ABillBlakely/Iridium-ADC/docs/project definition/Images/printed_enclosure.jpg

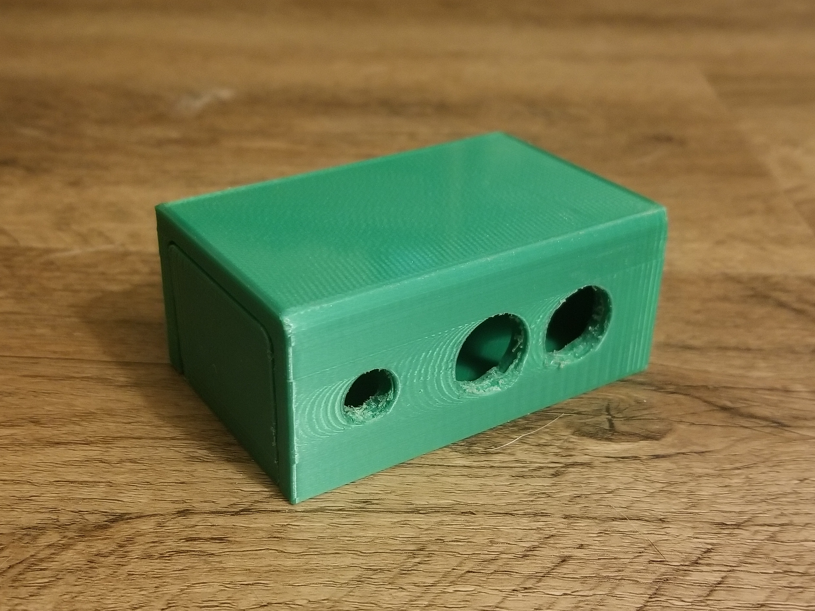
docs/project definition/Images/printed_enclosure.jpg
