ABillBlakely/Iridium-ADC/docs/project definition/Images/APx515.png

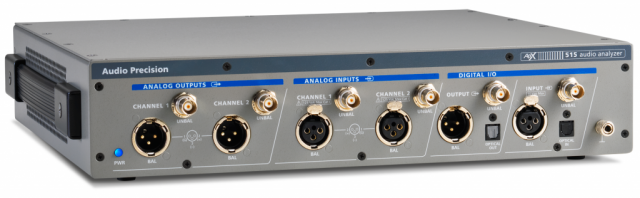
docs/project definition/Images/APx515.png
