ABillBlakely/Iridium-ADC/docs/project definition/Images/3dmodelandpic.png

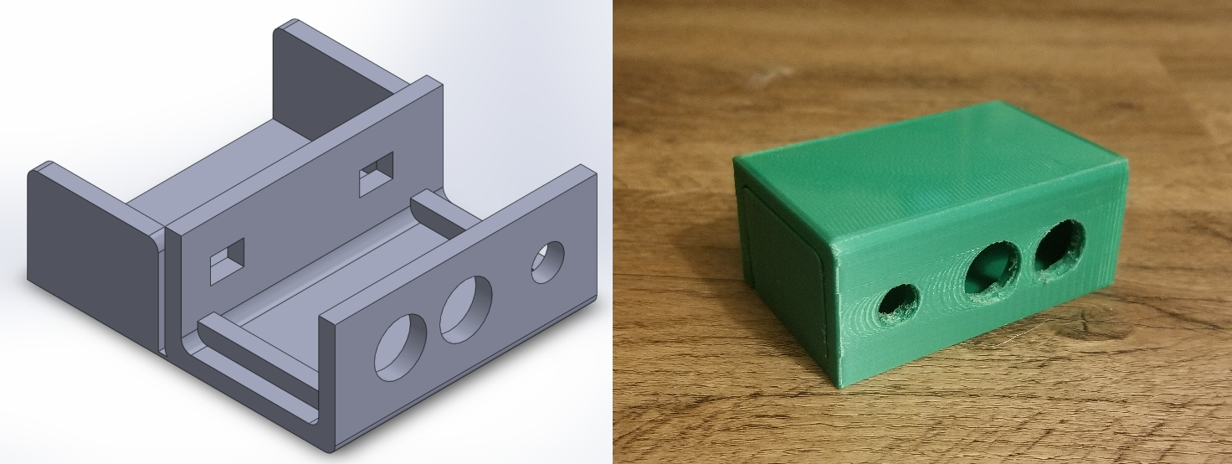
docs/project definition/Images/3dmodelandpic.png
