ABillBlakely/Iridium-ADC/docs/project definition/Images/ad7760_filter_response.png

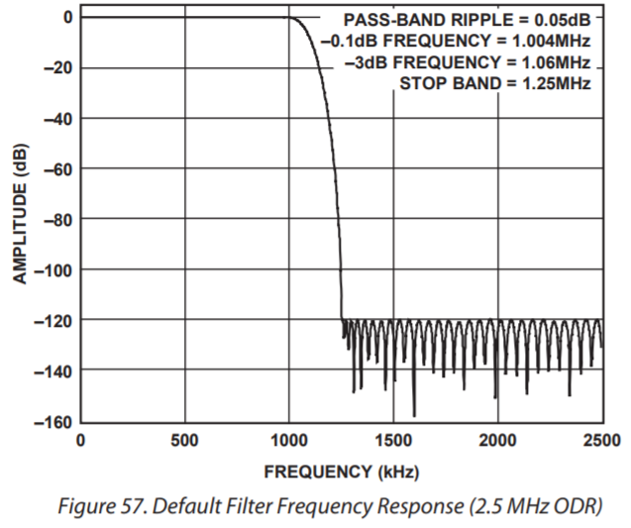
docs/project definition/Images/ad7760_filter_response.png
