ABillBlakely/Iridium-ADC/docs/project definition/Images/ads1675_filter_response.png

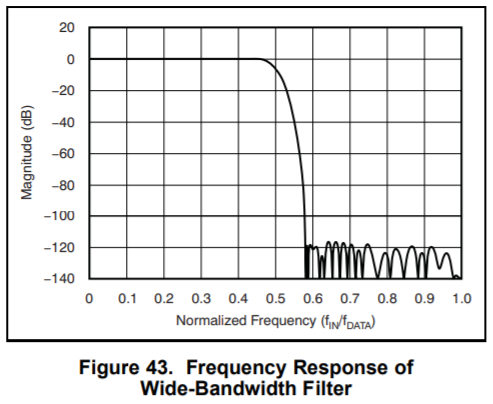
docs/project definition/Images/ads1675_filter_response.png
