ABillBlakely/Iridium-ADC/docs/project definition/Images/ak5578_filter_response.png

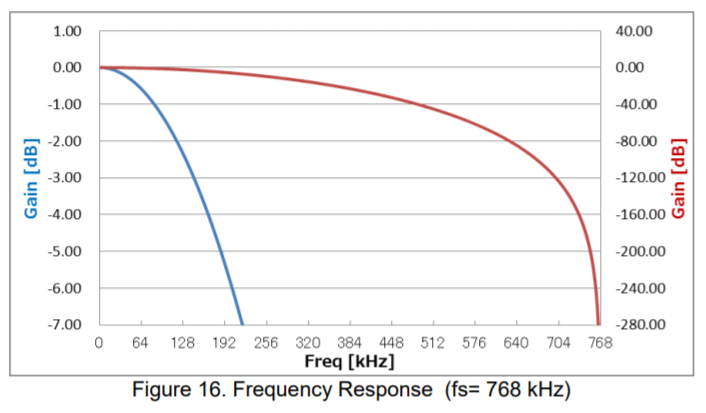
docs/project definition/Images/ak5578_filter_response.png
