ABillBlakely/Iridium-ADC/docs/project definition/Images/DNL.PNG

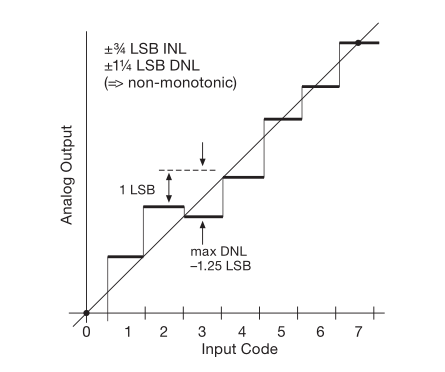
docs/project definition/Images/DNL.PNG
