ABillBlakely/Iridium-ADC/docs/project definition/Images/INL.PNG

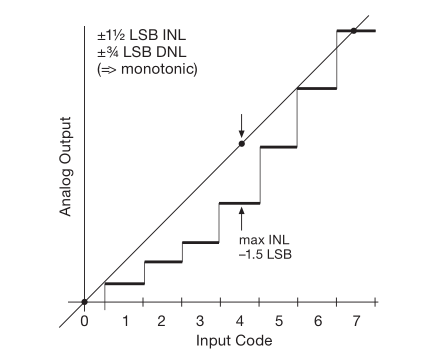
docs/project definition/Images/INL.PNG
