ABillBlakely/Iridium-ADC/docs/project definition/Images/PCBFront.png

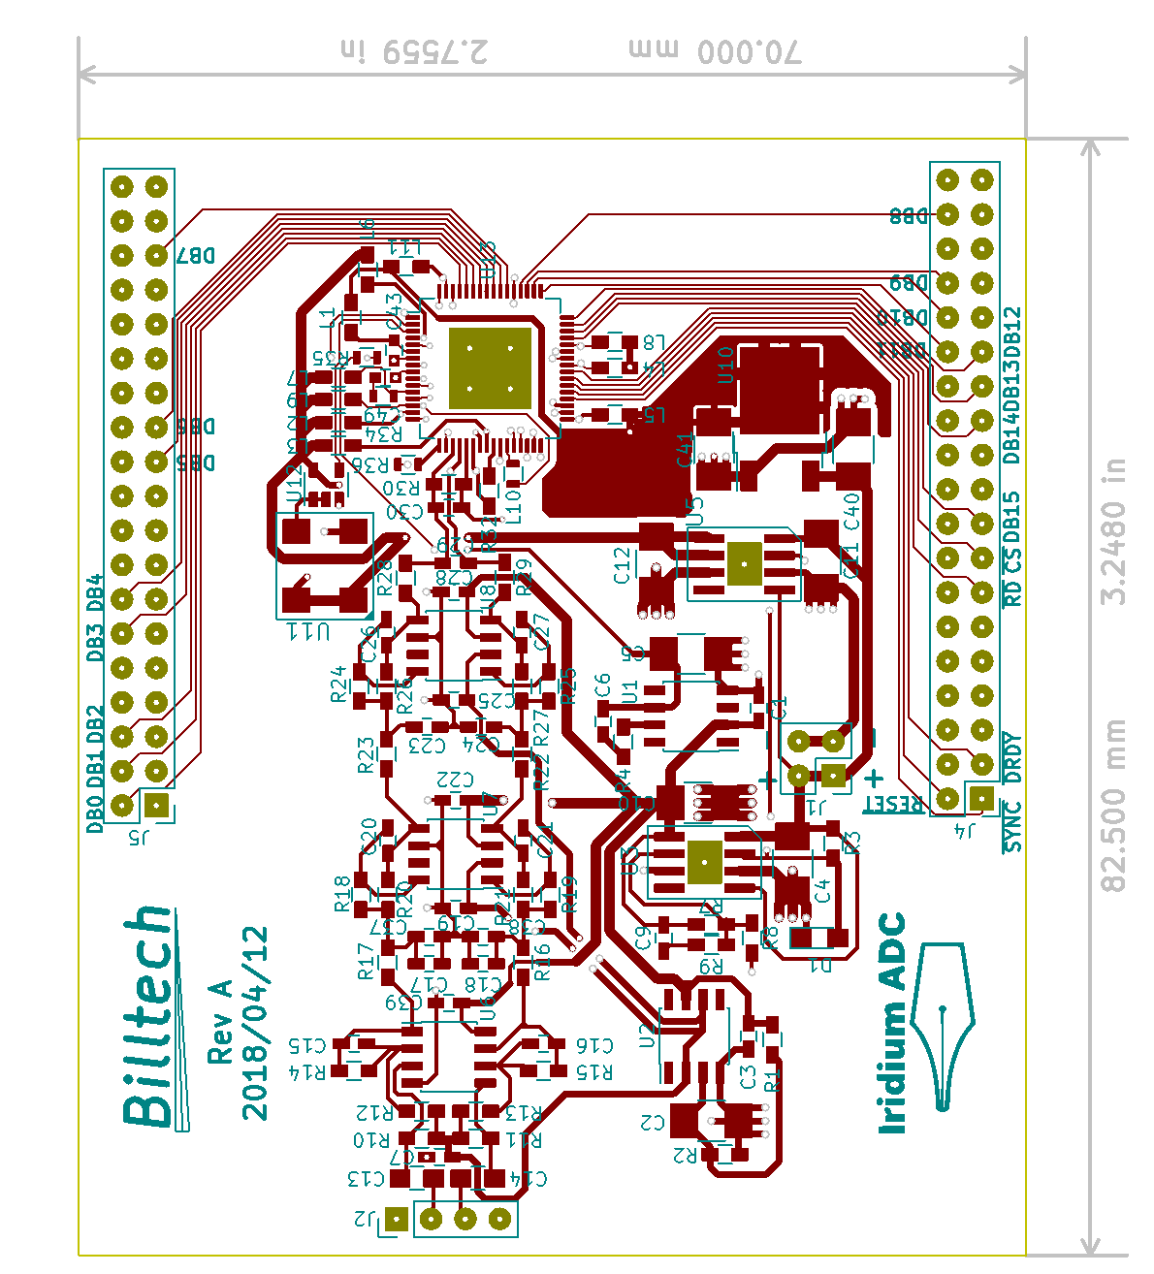
docs/project definition/Images/PCBFront.png
