ABillBlakely/Iridium-ADC/docs/project definition/Images/scarlett.jpg

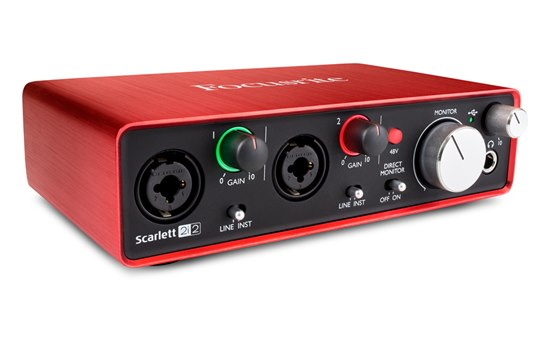
docs/project definition/Images/scarlett.jpg
