ABillBlakely/Iridium-ADC/docs/project definition/Images/schemInput.png

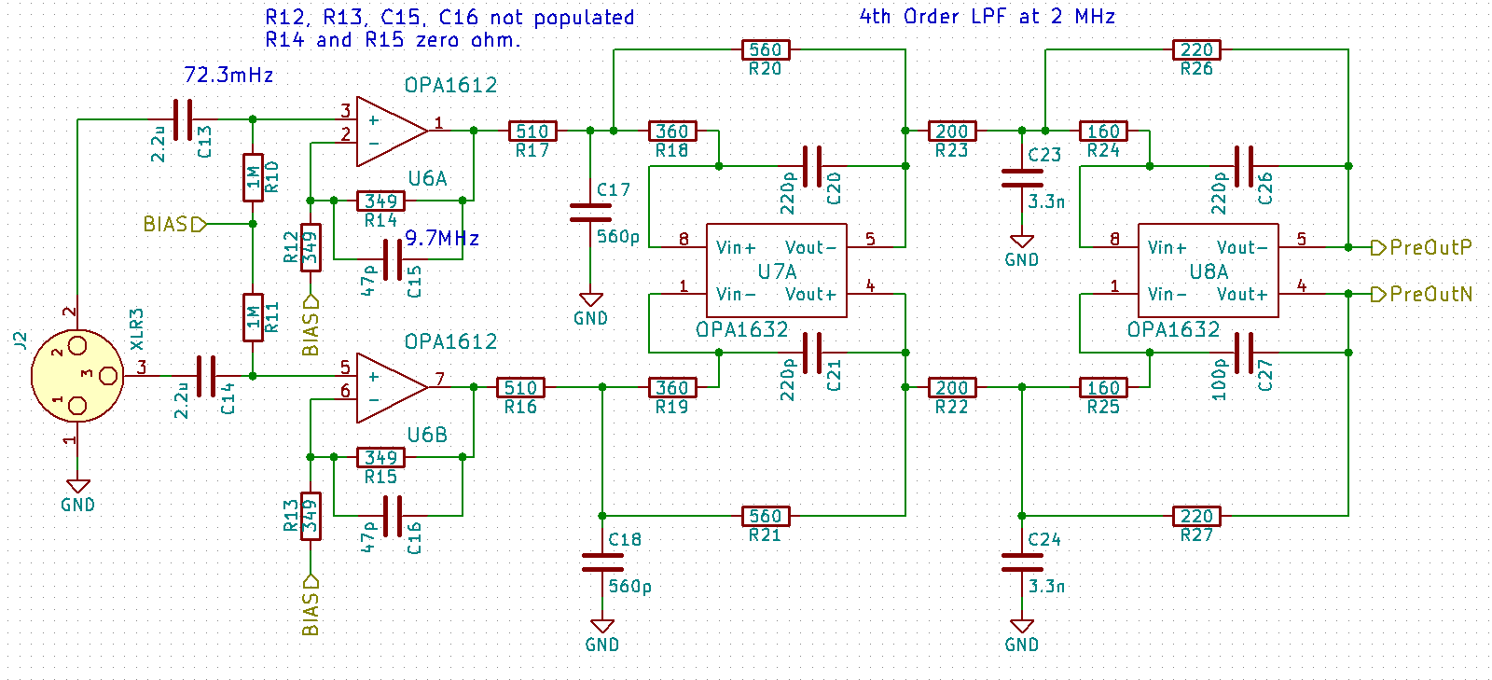
docs/project definition/Images/schemInput.png
