ABillBlakely/Iridium-ADC/docs/project definition/Images/schemReference.png

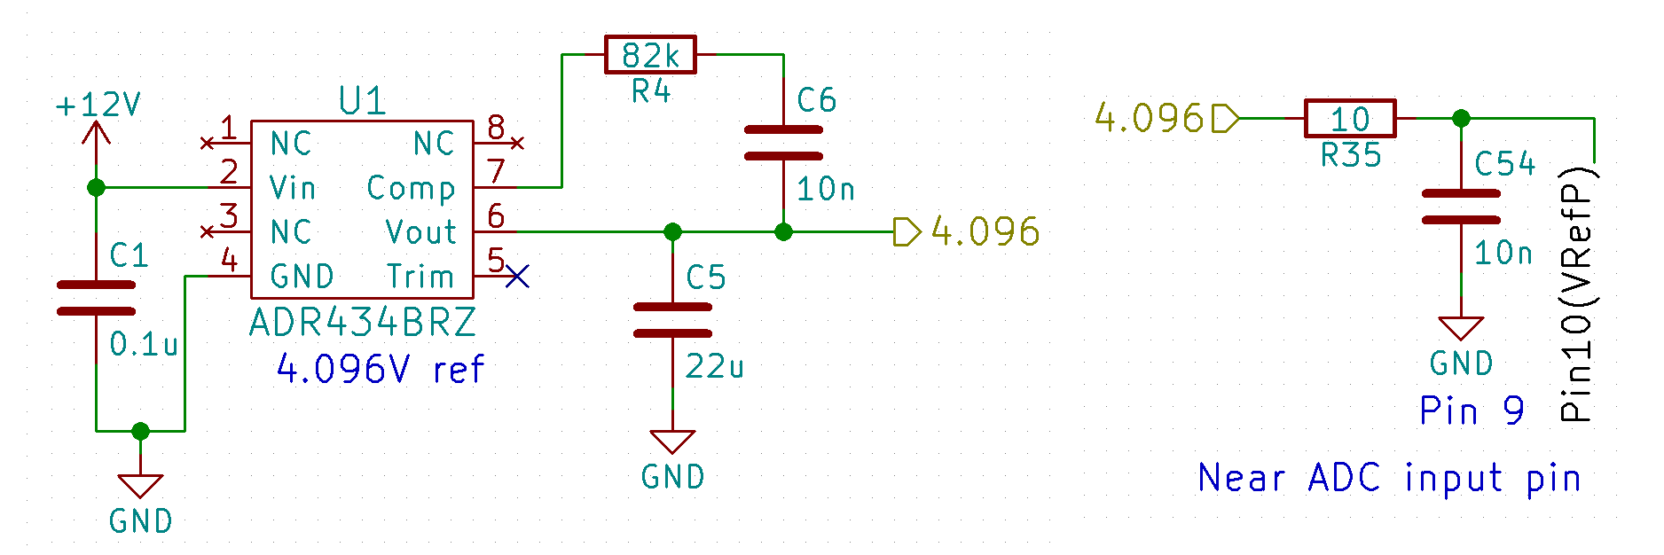
docs/project definition/Images/schemReference.png
