ABillBlakely/Iridium-ADC/docs/project definition/Images/typLabDist.png

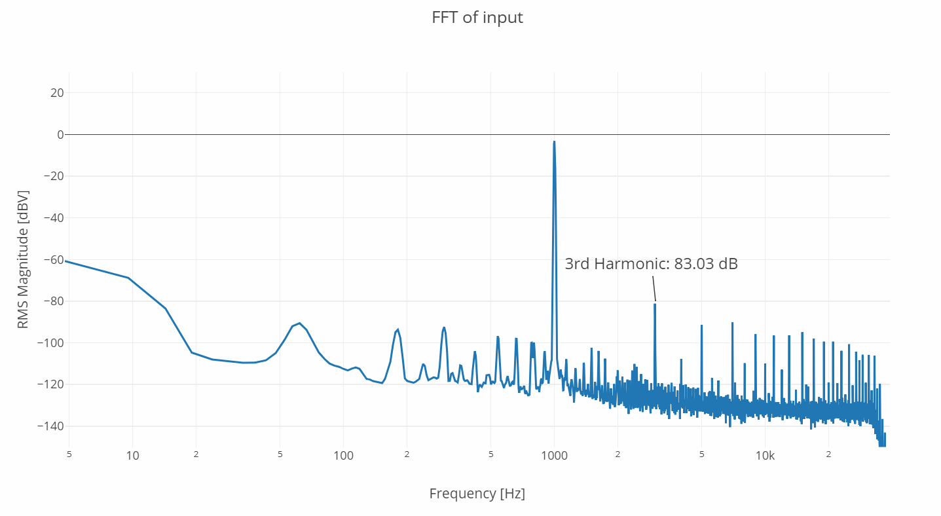
docs/project definition/Images/typLabDist.png
