ABillBlakely/Iridium-ADC/hardware/3d Model/CFP_Case print version 0.curaproject.3mf

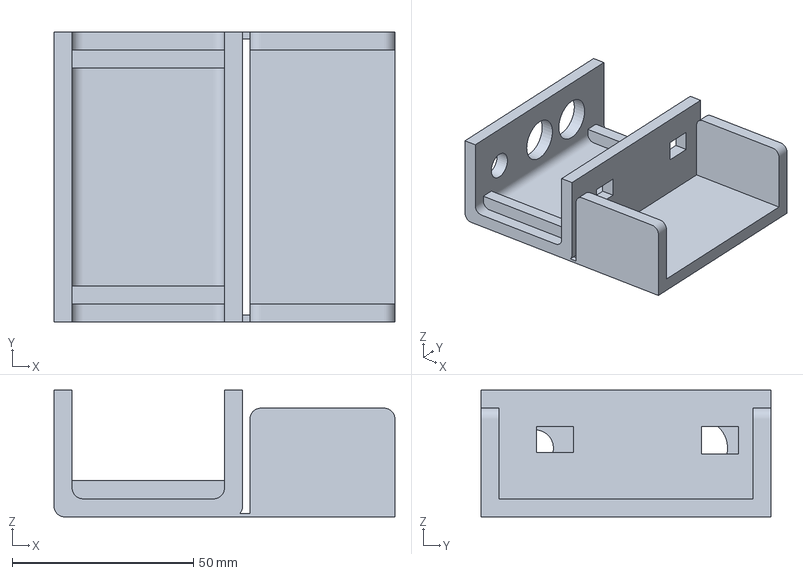
[picture p144: CAD file, 2017-12-01]
hardware/3d Model/CFP_Case print version 0.curaproject.3mf
94.0 x 80.0 x 35.0 mm
