ABillBlakely/Iridium-ADC/(list of files, cad)

Other CAD files:
hardware/3d Model/Case print version 0.STL
hardware/3d Model/Case.SLDPRT
