ABillBlakely/Iridium-ADC/docs/project definition/Images/measureDist+6dB1kHz.png

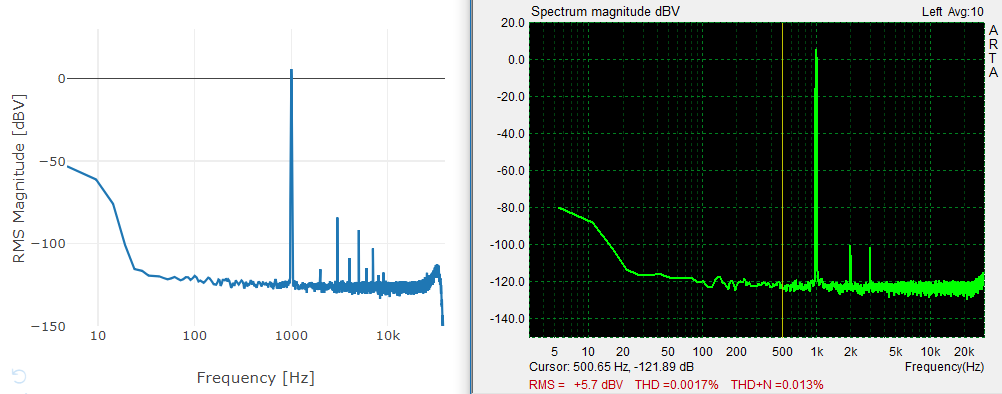
docs/project definition/Images/measureDist+6dB1kHz.png
