ABillBlakely/Iridium-ADC/docs/project definition/Images/measureDist-3dB10kHz.png

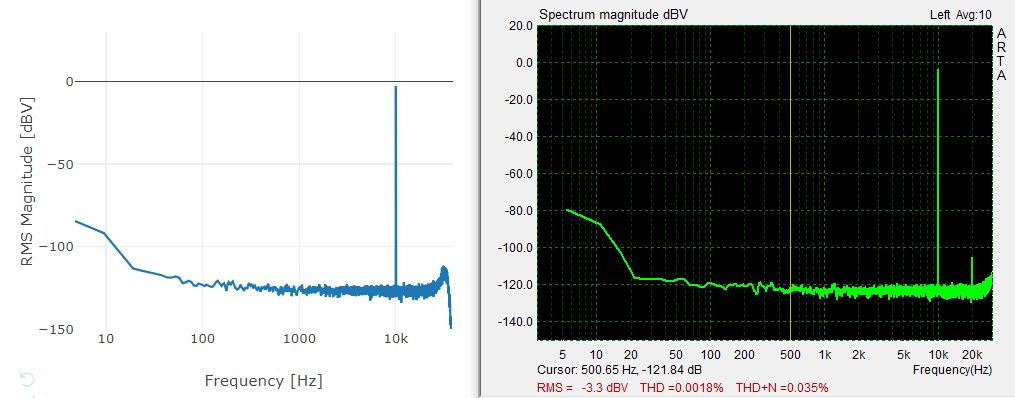
docs/project definition/Images/measureDist-3dB10kHz.png
