ABillBlakely/Iridium-ADC/docs/project definition/Images/measureFreqResponse.png

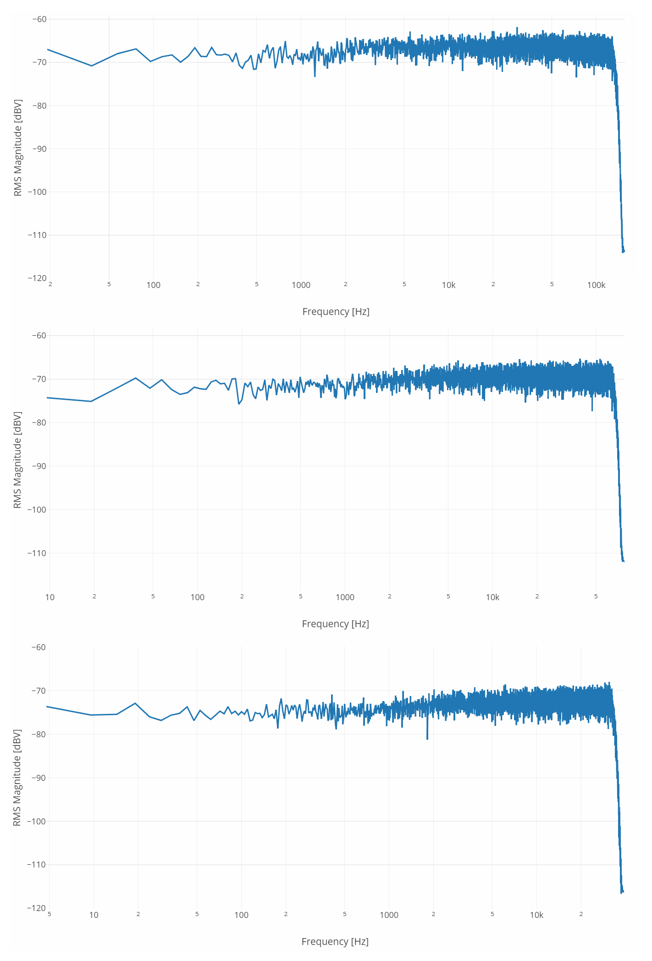
docs/project definition/Images/measureFreqResponse.png
