ABillBlakely/Iridium-ADC/hardware/3d Model/Case.PDF

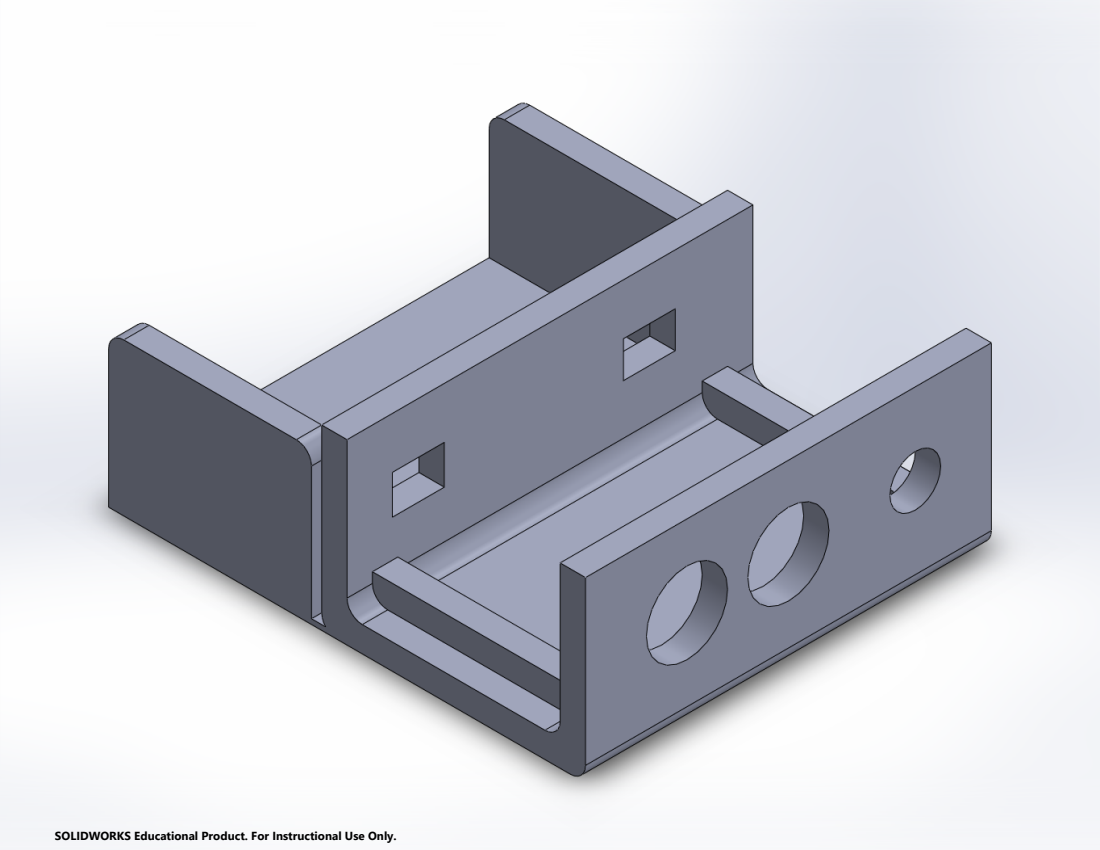
[picture p148: page 1]

SOLIDWORKS Educational Product. For Instructional Use Only.
