ABillBlakely/Iridium-ADC/esim/analog frontend stability stage 2.asc

C7: cap; 1.5n
C8: cap; 100p
C12: cap; 1.5n
C13: cap; 100p
R13: res; 1k
R15: res; 367
R16: res; 332
R17: res; 220
R18: res; 332
R19: res; 220
R20: res; 367
R22: res; 1k
U4: OPA1632
V1: voltage; 12
V5: voltage; 0; AC 1
V6: voltage; 0; AC -1
Named nets: 0, Vcc, vcc, in2, fb2, fb1, in1
.ac dec 100 1 200Meg
