ABillBlakely/Iridium-ADC/esim/analog frontend.asc

C1: cap; 240p
C2: cap; 100p
C3: cap; 240p
C4: cap; 100p
C5: cap; 1.5n
C6: cap; 100p
C7: cap; 1.5n
C8: cap; 100p
C9: cap; 100p
C10: cap; 120p
C11: cap; 120p
C12: cap; 2.2µ
C14: cap; 2.2µ
R1: res; 1Meg
R2: res; 1Meg
R7: res; 1.05k
R8: res; 698
R9: res; 1.05k
R10: res; 1.05k
R11: res; 698
R12: res; 1.05k
R13: res; 367
R14: res; 332
R15: res; 220
R16: res; 332
R17: res; 220
R18: res; 367
R19: res; 1k
R20: res; 655
R21: res; 18
R22: res; 1k
R23: res; 655
R24: res; 18
U1: UniversalOpamp2; Avol=1Meg GBW=40Meg Slew=27Meg
U2: UniversalOpamp2; Avol=1Meg GBW=40Meg Slew=27Meg
U3: OPA1632
U4: OPA1632
U5: OPA1632
V1: voltage; SINE(0 1 1k); AC 1; Rser=50
V2: voltage; 6
V3: voltage; 12
V4: voltage; 2.048
Named nets: outP, Vcc, outN, ocm, vcc, bias, 0, INP, INN
.ac dec 100 1 50Meg
;.noise V(outP, outN) V1 dec 100 1 1Meg
;.tran 0 4m 0 1u
The last op amp represents
the ADC's built in diff amp
These opamp models have 
OPA1612 parameters inserted
