ABillBlakely/Iridium-ADC/esim/analog frontend stability.asc

C1: cap; 240p
C2: cap; 100p
C5: cap; 240p
C6: cap; 100p
C7: cap; 1.5n
C8: cap; 100p
C12: cap; 1.5n
C13: cap; 100p
R1: res; 1Meg
R2: res; 1Meg
R7: res; 1.05k
R8: res; 698
R9: res; 1.05k
R10: res; 1.05k
R11: res; 698
R12: res; 1.05k
R13: res; 1k
R15: res; 357
R16: res; 332
R17: res; 220
R18: res; 332
R19: res; 220
R20: res; 357
R22: res; 1k
U1: UniversalOpamp2; Avol=1Meg GBW=40Meg Slew=27Meg
U2: UniversalOpamp2; Avol=1Meg GBW=40Meg Slew=27Meg
U3: OPA1632
U4: OPA1632
V1: voltage; 10
V2: voltage; -10
V3: voltage; 0; AC 0; Rser=1k
V4: voltage; 2.048
V5: voltage; 0; AC 1
V6: voltage; 0; AC 1
Named nets: 0, Vcc, Vee, vcc, vee, ocm, in2, fb2, fb1, in1
.ac dec 100 1 10G
;.noise V(out+) V1 dec 100 1 100Meg
;.tran 0 100m 0 1u
.options plotwinsize 0
8 V diff, 4 V single ended.
+/-2.5 V, 5V max differential
