ABillBlakely/Iridium-ADC/(list of files, drawings)

Other design files:
esim/OPA1612_PSPICE_AIO/OPA1612.DSN
esim/OPA1612_PSPICE_AIO/OPA1612.OLB
esim/OPA1612_PSPICE_AIO/OPA1612.opj
