ABillBlakely/Iridium-ADC/ecad/Iridium-adc.kicad_pcb

## KiCad design ecad/Iridium-adc.kicad_pcb (2018-04-13)

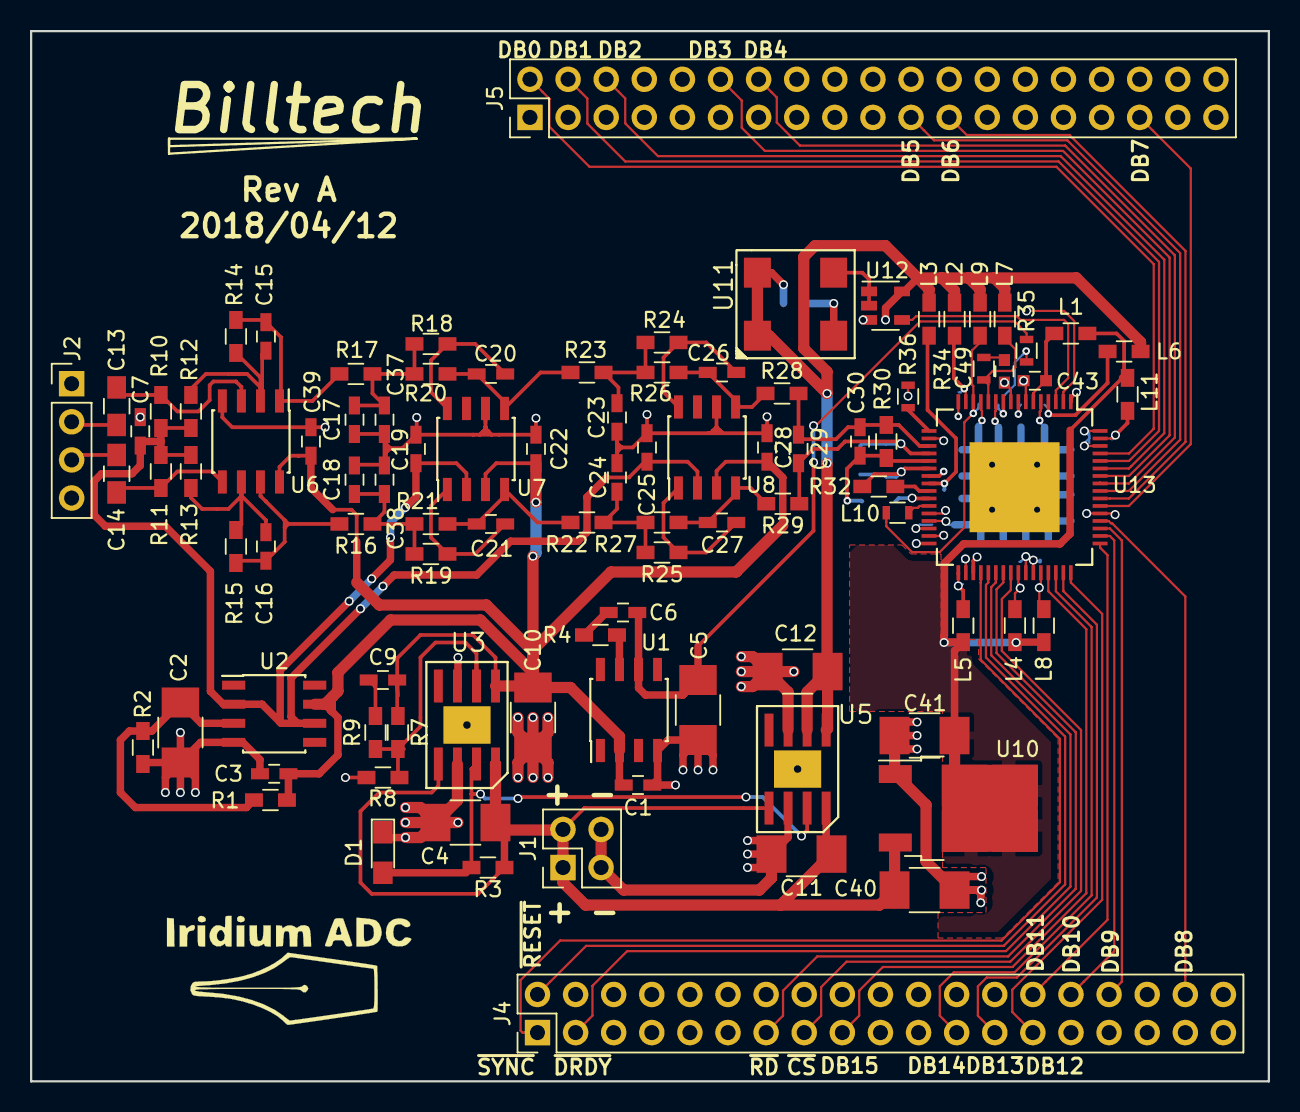
[picture p149: board Iridium-adc.kicad_pcb from above]

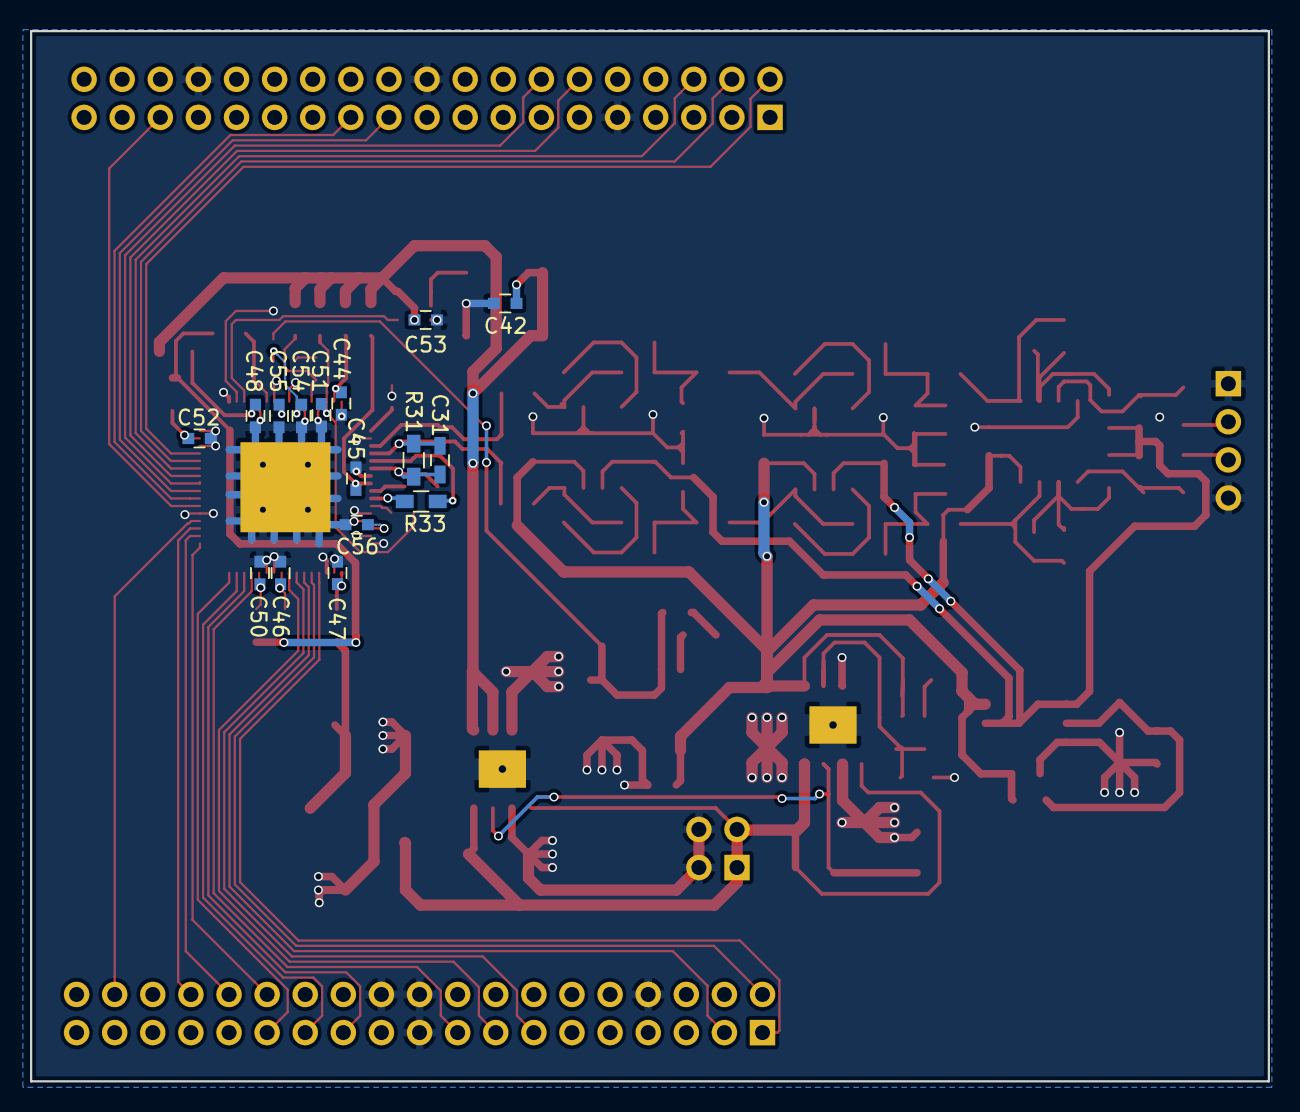
[picture p150: board Iridium-adc.kicad_pcb from below]

Board: 2 copper layers, 82.5 x 70.0 mm, 111 parts (16 on the bottom side), 78 nets.

Parts:
C1, C3, C7, C19, C22, C25, C28, C39: 0.1u; C_0603_HandSoldering
C2, C4, C5, C10, C11, C12, C40, C41: 22u; C_1210_HandSoldering
C6: 10n; C_0603_HandSoldering
C9: 39n; C_0603_HandSoldering
C13, C14: 2.2u; C_0805_HandSoldering
C15, C16: 47p; C_0603_HandSoldering
C17, C18: 220p; C_0603_HandSoldering
C20, C21, C26, C27, C29: 100p; C_0603_HandSoldering
C23, C24: 1.5n; C_0603_HandSoldering
C30, C31: 120p; C_0603_HandSoldering
C37, C38: 20p; C_0603_HandSoldering
C42, C43, C44, C45, C46, C47, C48, C50, C51, C52, C53, C55: 0.1u; C_0603
C49, C54: 10n; C_0603
C56: 33p; C_0603
D1: LED; LED_0805_HandSoldering
J1: +15V; Pin_Header_Straight_2x02_Pitch2.54mm
J2: XLR3; Pin_Header_Straight_1x04_Pitch2.54mm
J4: Nucleo_F446_LHS; Pin_Header_Straight_2x19_Pitch2.54mm
J5: Nucleo_F446_RHS; Pin_Header_Straight_2x19_Pitch2.54mm
L1, L2, L3, L4, L5, L6, L7, L8, L9, L11: 1k@100M; L_0603_HandSoldering
L10: 15n; L_0603
R1, R2, R3, R8, R9: 10k; R_0603_HandSoldering
R4: 82k; R_0603_HandSoldering
R7: 86k6; R_0603_HandSoldering
R10, R11: 1M; R_0603_HandSoldering
R12, R13, R14, R15: 349; R_0603_HandSoldering
R16, R17, R20, R21: 1k05; R_0603_HandSoldering
R18, R19: 698; R_0603_HandSoldering
R22, R23: 367; R_0603_HandSoldering
R24, R25: 332; R_0603_HandSoldering
R26, R27: 220; R_0603_HandSoldering
R28, R29: 1k; R_0603_HandSoldering
R30, R31: 655; R_0603_HandSoldering
R32, R33: 18; R_0603_HandSoldering
R34, R35: 10; R_0603
R36: 160k; R_0603
U1: ADR434BRZ; SOIC-8_3.9x4.9mm_Pitch1.27mm
U2: OPA207IDR; SOIC-8_3.9x4.9mm_Pitch1.27mm
U3: ADP7105ARDZ; SOIC-8-EP
U5: ADP7104ARDZ-5.0; SOIC-8-EP
U6: OPA1612; SOIC-8_3.9x4.9mm_Pitch1.27mm
U7, U8: OPA1632; SOIC-8_3.9x4.9mm_Pitch1.27mm
U10: NCV1117ST25T3G; TO-252-2
U11: CB3-3C-40M0000; CTS_CB3_oscillator
U12: NC7SZ08M5; SOT-23-5
U13: AD7760; LQFP-EP-64_10x10mm_Pitch0.5mm_6mm_square_paddle

Connections:
+2V5: C41.1, L1.1, L4.1, L5.1, L8.1, L11.1, U10.2
+5V: C12.1, C42.1, C53.1, L2.1, L3.1, L6.1, L7.1, L9.1, U5.1, U5.2, U11.1, U11.4, U12.5
+12V: C1.1, C3.2, C9.1, C10.1, C22.1, C28.1, C39.1, R1.1, R7.1, U1.2, U2.7, U3.1, U6.8, U7.3, U8.3
+15V: C4.1, C11.1, C40.1, J1.1, J1.2, R3.1, U3.5, U3.8, U5.5, U5.8, U10.3
/ADC/4.096: C5.1, C6.2, R35.2, U1.6
/ADC/DB0: J5.2, U13.61
/ADC/DB1: J5.4, U13.60
/ADC/DB2: J5.6, U13.59
/ADC/DB3: J5.12, U13.58
/ADC/DB4: J5.14, U13.57
/ADC/DB5: J5.21, U13.56
/ADC/DB6: J5.23, U13.55
/ADC/DB7: J5.33, U13.54
/ADC/DB8: J4.36, U13.52
/ADC/DB9: J4.32, U13.51
/ADC/DB10: J4.30, U13.50
/ADC/DB11: J4.28, U13.49
/ADC/DB12: J4.27, U13.48
/ADC/DB13: J4.25, U13.47
/ADC/DB14: J4.23, U13.46
/ADC/DB15: J4.17, U13.45
/ADC/InputN: C27.1, R27.1, R29.2, U8.4
/ADC/InputP: C26.1, R26.1, R28.2, U8.5
/ADC/MCLK: U12.4, U13.3
/ADC/Pin4(RHS): C48.1, L6.2, U13.4
/ADC/Pin6(Vmod1): C43.1, L1.2, U13.6
/ADC/Pin10(VRefP): C54.1, R35.1, U13.10
/ADC/Pin12(Vbuf): L7.2, R34.1, U13.12
/ADC/Pin14(LHS): C51.1, L9.2, L10.1, U13.14
/ADC/Pin15(Vbias): C44.1, L2.2, U13.15
/ADC/Pin24(VDif1): C45.1, L3.2, U13.24
/ADC/Pin27: L10.2, U13.27
/ADC/Pin33(Vmod2): C47.1, L5.2, U13.33
/ADC/Pin41(DVdd): C46.1, L4.2, U13.41
/ADC/Pin44(Vdrive1): C50.1, L8.2, U13.44
/ADC/Pin63(Vdrive2): C52.1, L11.2, U13.63
/ADC/VINAN: C29.1, C31.2, R29.1, R31.2, U13.20
/ADC/VINAP: C29.2, C30.2, R28.1, R30.2, U13.19
/ADC/VINN: R33.1, U13.26
/ADC/VINP: R32.1, U13.25
/ADC/VOUTAN: C30.1, R30.1, R33.2, U13.21
/ADC/VOUTAP: C31.1, R31.1, R32.2, U13.22
/ADC/~CS: J4.15, U13.40
/ADC/~DRDY: J4.3, U13.38
/ADC/~RD: J4.13, U13.39
/ADC/~RESET: J4.2, U13.37
/ADC/~SYNC: J4.1, U13.36
/Input/BIAS: C7.1, C19.1, C25.1, R10.2, R11.1, R12.1, R13.1, U2.2, U2.6, U7.2, U8.2
GND: C1.2, C2.2, C3.1, C4.2, C5.2, C7.2, C10.2, C11.2, C12.2, C17.2, C18.2, C19.2, C22.2, C23.2, C24.2, C25.2, C28.2, C37.2, C38.2, C39.2, C40.2, C41.2, C42.2, C43.2, C44.2, C45.2, C46.2, C47.2, C48.2, C49.2, C50.2, C51.2, C52.2, C53.2, C54.2, C55.2, C56.2, D1.1, J1.3, J1.4, J2.1, J2.4, J4.8, J4.19, J4.20, J4.22, J5.9, J5.20, J5.32, R2.2, R8.2, R36.2, U1.4, U2.4, U3.3, U3.6, U3.9, U5.3, U5.6, U5.9, U6.4, U7.6, U8.6, U10.1, U11.2, U12.3, U13.1, U13.2, U13.5, U13.7, U13.9, U13.11, U13.13, U13.16, U13.18, U13.23, U13.28, U13.29, U13.31, U13.32, U13.34, U13.35, U13.42, U13.43, U13.53, U13.62, U13.64, U13.65
unnamed: C2.1, R1.2, R2.1, U2.3
unnamed: C6.1, R4.1
unnamed: C9.2, R9.1
unnamed: C13.1, R10.1, U6.3
unnamed: C13.2, J2.2
unnamed: C14.1, R11.2, U6.5
unnamed: C14.2, J2.3
unnamed: C15.1, R14.1, R17.2, U6.1
unnamed: C15.2, R12.2, R14.2, U6.2
unnamed: C16.1, R15.1, R16.2, U6.7
unnamed: C16.2, R13.2, R15.2, U6.6
unnamed: C17.1, C37.1, R17.1, R18.2, R20.2
unnamed: C18.1, C38.1, R16.1, R19.2, R21.2
unnamed: C20.1, R20.1, R23.2, U7.5
unnamed: C20.2, R18.1, U7.8
unnamed: C21.1, R21.1, R22.2, U7.4
unnamed: C21.2, R19.1, U7.1
unnamed: C23.1, R23.1, R24.2, R26.2
unnamed: C24.1, R22.1, R25.2, R27.2
unnamed: C26.2, R24.1, U8.8
unnamed: C27.2, R25.1, U8.1
unnamed: C49.1, R34.2
unnamed: C55.1, U13.8
unnamed: C56.1, U13.30
unnamed: D1.2, R3.2, U3.7, U5.7
unnamed: R4.2, U1.7
unnamed: R7.2, R8.1, R9.2, U3.2
unnamed: R36.1, U13.17
unnamed: U11.3, U12.1, U12.2
