ABillBlakely/Iridium-ADC/(commit log)

2017-12-01 In progress Project Definition and inital 3D Model.
    [CFP_Case print version 0.curaproject.3mf, Case print version 0.STL, Case.SLDPRT]
2018-02-05 Setup environment for mbed RTOS
    [CFP_Case print version 0.curaproject.3mf, Case print version 0.STL, Case.SLDPRT, ethernet.cfg, ethernet_host.cfg, generic.cfg, iridium_map.csv, local_socket.cfg]
2018-02-23 Clean and organize directory a little.
    [Iridium-adc.kicad_pcb, Iridium-adc.sch, OPA1612.DSN, OPA1612.OLB, OPA1612.opj, adc.sch, input.sch, iridium_map.csv]
2018-02-23 Restructure src file, clean directory, update readme and src\readme
    [src_map.csv]
2018-04-04 Mostly complete schematic, about to tape out the PCB.
    [Iridium-adc.sch, adc.sch, input.sch, microcontroller.sch, power-supply.sch]
2018-04-11 First complete pass of PCB with preamp, ADC, and nucleo dev board connections.
    [Iridium-adc.kicad_pcb, adc.sch, input.sch, microcontroller.sch, power-supply.sch]
2018-04-13 Rev A of board as ordered from Osh Park.
    [Iridium-adc.kicad_pcb, input.sch, microcontroller.sch, power-supply.sch]
2018-04-18 build some test to verify pins of dev board.
2018-04-20 Write initialization routine (untested), move pin defs to own file.
2018-04-20 Source track binary file.
    [Iridium-adc.csv, adc.sch, input.sch, microcontroller.sch, src_map.csv]
2018-04-24 Write function to efficiently use the databus and use an interruppt on the ~DRDY pin. UNTESTED
2018-04-25 Sort out all necessary pin changes.
    [microcontroller.sch]
2018-04-25 Matlab file simulating sample data and the effects of quantization and noise.
2018-04-25 set sample array as volatile, reinstate data disentaglement. This should be considered the starting performance benchmark at 570 kSPS.
2018-04-25 Switch strategies from disentagle to efficient packing. 745 kSPS
2018-05-08 mbed directory clean up, configure for merge to main branch and testing of board.
2018-05-08 Correct part name from adp7104 to adp7105, which has a soft start feature.
    [power-supply.sch]
2018-05-08 Fix status register display to show decimation as a single decimal value.
    [adc.cpp]
2018-05-08 Change pin from pc_7 to pa_5
    [microcontroller.sch]
2018-05-09 Writing to buffer appears to be correct code but decimation rate setting is not functional.
    [adc.cpp, adc.h, main.cpp, pins.cpp, pins.h]
2018-05-10 Sampling is happening, not sure if it is happening correctly yet.
    [adc.cpp, adc.h, main.cpp, pins.cpp, pins.h]
2018-05-10 Create a class structure for the adc functions.
2018-05-11 term control attempt not working.
    [adc.cpp, adc.h, main.cpp, pins.cpp, pins.h]
2018-05-15 Python gui using dash and plotly to view and control the adc.
2018-05-16 Attempts to change the decimation rate in the UI have led to this point.
2018-05-16 A new approach to communication using two way signaling. Not currently working
2018-05-17 Running stably at 115200 baud. Decimation switch untested."
2018-05-17 Working at 2 Mbps baud rate. Removed some unnecessary print and other statements.
2018-05-19 Change Pin PA5 to PC7. Create two way communication scheme. UNTESTED
    [microcontroller.sch]
2018-05-21 Tweak the MCU code to operate on poll instead of interrupt
2018-05-21 Back to interrupt driven, polling misses some events. The delay adding in between data bus reads was the critical component. Reliably working sampling now.
2018-05-22 Simulation agrees that the input range is less than required to overload the adc input. This is due to forgetting the factor of two in the differential signals during desing, so each attenuation is a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
2018-05-22 Move to propagation updates instead of entirely timer driven.
2018-05-23 scale windows correctly, hide decimation selection while it is not working.
    [adc.cpp, adc.h, adc_comms.py, communications.cpp, pc_data.py]
2018-05-25 Hardware changes for bias voltage osc fix and planned preamp gain correction part selection.
    [_saved_input.sch, microcontroller.sch]
2018-05-25 Approx DC offset and scale factor set.
    [_saved_input.sch, input.sch]
2018-05-25 Add button to show the window in the time domain graph.
2018-05-28 Restructure GUI, implement sample rate and number of sample switchability.
2018-06-04 Slight changes to simulation and ecad with new changes before rollback to old changes.
    [Iridium-adc.sch, adc.sch, input.sch, microcontroller.sch, power-supply.sch]
2018-06-09 Commit it all and let God^H^H^H diff sort it out.
    [microcontroller.sch]
